disha2993/Indoor-localization-using-ultrasound/Sonar Amp.asc

C1: cap; 0.1µ
C2: cap; 0.1
D1: diode; 1N4148
R1: res; 47k
R2: res; 10k
R3: res; 10k
R4: res; 10k
R5: res; 10k
R6: res; 10k
R7: res; 10k
R8: res; 10k
R9: res; 10k
R10: res; 4,7k
R11: res; 470
R12: res; 47k
R13: res; 1k
U1: LTC1052
U2: LTC1052
U3: LTC1052
V1: voltage; 5v
Vnoise: voltage; SINE(0 .01 4k)
Vsonar: voltage; SINE(0 .02 24.2k 0.0001 0 0 10)
Named nets: 0, 5v, IN, FILT_OUT, 5V, RECT_OUT, COMP_OUT
.tran 0 500u 0
